xmyoot/esp32c6-epaper-calendar/analysis/report-workflow-tail.txt

### Signal Integrity
[Layer transitions per net, ground return path assessment, trace proximity/crosstalk (with --proximity flag)]

Differential pair length matching: For each detected differential pair (USB D+/D-, Ethernet TX+/TX-, etc.), compute the length delta between the two traces and cite the protocol-specific tolerance. The delta and tolerance are more useful than the raw lengths alone — they tell the designer whether there's margin or a problem. Example format: "D+=75.8mm, D-=75.2mm (delta=0.6mm — within USB 2.0 FS tolerance of ±25mm)." For interfaces with tighter requirements: USB 3.x ±3mm, HDMI ±2mm, DDR ±0.5mm.

### Power & Ground
[Power net routing summary (width, length, current capacity), ground domain identification (AGND/DGND/PGND), zone stitching via density]

### Thermal Analysis
[Thermal pad detection, via counting and adequacy for QFN/DFN packages, zone stitching density, thermal relief settings, tombstoning risk assessment (0201/0402 thermal asymmetry). Cross-reference thermal via count and pad area against each IC's datasheet thermal management section — check recommended via count, via diameter, and exposed pad connection. Verify θJA assumptions match the datasheet's specified board conditions (e.g., JEDEC 2s2p vs actual layer count).

When `analyze_thermal.py` was run, include its junction temperature estimates (Tj per component, margin to Tj_max, thermal score). Cross-reference against datasheet Tj_max values. When the thermal script was not run, estimate manually from power dissipation and package θJA for components with significant power draw (regulators, drivers, power FETs).]

For every IC with an exposed/thermal pad, explicitly report the via count and adequacy in this format: "[Ref] pad [N] ([net]) connected through [count] thermal vias (recommended range: [min]–[max] per datasheet) — [adequate/insufficient]." Example: "U1 pad 41 (GND thermal pad) connected through 12 thermal vias (recommended range: 9–16) — adequate." The thermal via count is one of the most common QFN/DFN layout errors and is always worth calling out with a specific number, even when adequate — it confirms the designer got it right.

### Copper Presence
[Zone copper at component pad locations — from `copper_presence` section. Focus on `no_opposite_layer_copper` list: which components lack zone copper on the opposite layer? Verify this is intentional for capacitive touch pads and antennas (need isolation) vs unexpected for other components (might indicate a zone gap). Also note `same_layer_foreign_zones` — pads sitting on zones they're not connected to, which is normal for tightly-packed power island zones but worth flagging if unexpected.]

### Capacitive Touch Pads
[Include when TP-prefixed components or pad-only footprints appear in `copper_presence.no_opposite_layer_copper`, or when touch controller ICs are detected]

| Pad | Diameter/Size | Position | Opposite-Layer Copper | Keepout Zone? | GND Pour Clearance | Trace Width | Trace Length to Controller |
|-----|---|---|---|---|---|---|---|
| [ref] | [mm] | [x, y] | [none / present (CRITICAL)] | [yes — (x1,y1) to (x2,y2) / NO — flag WARNING] | [distance mm vs app note min] | [mm] | [mm — compare across pads] |

Copper absence vs keepout enforcement: Confirming "no copper" under a touch pad is necessary but not sufficient. That absence could be accidental — a routing change or zone adjustment could fill in copper and kill touch sensitivity. A keepout zone is a DRC rule that prevents this permanently. Check the PCB file for explicit keepout/rule-area objects on the opposite layer under each touch pad. If none exist, flag as WARNING: "no explicit keepout zone under [ref] — copper absence is not enforced by a DRC rule."

Trace length asymmetry: Compute the trace length from each touch pad to the controller IC and compare across all pads. Significant asymmetry (>1.5×) means different parasitic capacitance per channel, which shifts baseline readings and may reduce dynamic range even with firmware calibration. Report the ratio: "TOUCH_2 (41.6mm) is 1.75× longer than TOUCH_1 (23.7mm)."

GND pour clearance: Use the `touch_pad_gnd_clearance` section in `copper_presence` for measured clearance values (`gnd_clearance_mm` per touch pad). Compare against the touch controller's recommended minimum (typically 1.0mm for Espressif, check the specific controller's app note). If the clearance is exactly at the minimum, note this: "GND clearance is 1.0mm — exactly the Espressif minimum. Consider increasing to 1.5mm if sensitivity is marginal." If `touch_pad_gnd_clearance` is not present, measure manually from the PCB layout.

### Antenna Layout
[Include when ANT-prefixed footprints, antenna lib_id patterns, or RF antenna footprints are detected, OR when wireless modules (ESP32, nRF, etc.) with integrated/PCB antennas are present]
- Keepout zone verification: check the `keepout_zones` section in the PCB analyzer output for restriction areas near the antenna footprint. Report the keepout zone coordinates, layer coverage, and restriction types explicitly: "Keepout zone on F.Cu+B.Cu: (x1, y1) to (x2, y2), restrictions: no copper pour, no tracks." The `nearby_components` field shows which components are near each keepout zone. Cross-reference dimensions against the manufacturer's reference layout — many antenna datasheets/app notes specify exact keepout areas.
- Ground plane termination: verify the ground plane ends at the antenna feed point and does not extend under the radiating element
- Matching network placement: components between antenna and RF IC should be close to the antenna with controlled-impedance traces
[If no keepout zones are defined around the antenna, flag as WARNING. For wireless modules (ESP32, nRF, etc.), the module vendor's reference design is the authoritative source for keepout dimensions — these are often the single most important layout constraint for RF performance. Always cite the specific antenna/module reference when verifying keepout adequacy: "Correct per Espressif guidelines" or "Matches nRF52840 reference layout."]

### Decoupling Placement
[Cap-to-IC distances for critical components, flag caps too far from IC power pins. Verify capacitor values and placement distances against each IC's datasheet requirements — many ICs specify maximum distance, minimum capacitance, and ESR limits for input/output decoupling. Flag any deviation from datasheet recommendations.

ESD protection ICs (entries with `category: "esd_bypass"` in the decoupling output) require a low-impedance bypass path for clamping. Their bypass cap should be within 3mm — flag WARNING if >5mm, SUGGESTION if 3-5mm. Common ESD ICs: USBLC6-2SC6, TPD4E05U06, PRTR5V0U2X, IP4220CZ6.]

### Current Capacity
[Per-net trace/via current capacity vs estimated load, narrow signal net warnings]

### DFM Assessment
[JLCPCB standard/advanced tier determination, DFM metrics (min trace width, min clearance, min drill, min annular ring), violation list. All threshold values MUST come from the "Fab House Capabilities" table in standards-compliance.md — do not substitute from memory.]

### Silkscreen
[Board text count, reference designator visibility, documentation warnings, values on silk]

### Connectivity
[Routing completeness, unrouted net count and list]

## Schematic ↔ PCB Cross-Reference
[Include when both schematic and PCB were analyzed — this catches the most dangerous bugs. Use `statistics.total_nets` from both analyzers for net count comparison — do not mix net counts from different sections or manual counting methods, as the schematic may include internal unnamed nets that the PCB doesn't.]
### Component Count Match — [Schematic (excl. power symbols) vs PCB footprint count]
### Pin-Net Verification — [ALL components: schematic pin mapping vs PCB pad mapping. Table: Ref | Pins | All Match | Mismatches. Do not sample — verify every component including connectors, transistors, diodes.]
This verification must happen at the PCB pad level, not just the schematic pin level. The schematic tells you pin 1 connects to net X; the PCB tells you pad 1 connects to net X. If the library footprint has pad numbering that doesn't match the symbol's pin numbering, the schematic and PCB will be internally consistent but the board will be wrong. For each IC, transistor, and connector, verify both directions: schematic pin N → net X, AND PCB pad N → net X, AND the physical pad position matches the datasheet's pin diagram for that specific package. Example format: "Q1: 1=G(MAP_RED), 2=S(GND), 3=D(+5V)." This catches the most dangerous class of bug — a library footprint with wrong pad numbering passes all consistency checks but produces a non-functional board.
### Connector Pinout Tables — [For connectors with >2 pins (debug headers, programming headers, multi-pin interfaces), include a pin mapping table]

| Connector | Pin | Net | Function |
|---|-----|-----|---|
| J1 | 1 | RESET | MCU reset |
| ... | ... | ... | ... |

[This is especially important for programming/debug headers, USB connectors, and board-to-board interfaces where miswiring is common and consequences are severe.]

### Footprint Match — [Schematic Footprint property vs actual PCB footprint]
### Value/MPN Consistency — [Spot-check values and MPNs between schematic and PCB]
### DNP Consistency — [Components marked DNP in schematic should not have routing on PCB]

## Gerber Analysis
[Include when gerber directory was analyzed]
### Layer Completeness — [Found vs missing required/recommended layers, source identification]
### Drill Classification — [Via count, component holes, mounting holes, classification method]
### Alignment Verification — [Layer alignment check, extent comparison]
### Pad Summary — [SMD vs THT aperture counts, via apertures, heatsink apertures]
### Board Dimensions — [From gerber extents, compare against PCB if both analyzed]

## Interface Summary
[One-line summary of each external interface: connector type, protection, protocol, pin mapping]
[Examples: USB-C (ESD: yes, CC: 5.1kΩ), SWD (J1, no ESD), CAN (120Ω term, PESD2CAN)]

## Quality & Manufacturing

### Assembly Complexity
[Score, SMD/THT ratio, difficulty breakdown (fine-pitch, BGA, QFN), dominant package, unique footprint count]

### Sourcing Audit
[MPN coverage %, missing MPNs list, missing distributor part numbers. Do not recommend or prefer any specific distributor by name — keep sourcing observations neutral.]

### Component Lifecycle Status
[**Include when `--lifecycle` flag was used on the schematic analyzer.** Report any NRND (not recommended for new designs), EOL (end of life), or obsolete components from the `lifecycle_audit` output. For each flagged part: MPN, current status, last-buy date if known, and suggested action (find alternate, stock up, redesign). If lifecycle audit was not run, note: "Lifecycle audit not performed — [reason: no API keys / no network / no MPNs]."]

### BOM Optimization
[Unique passive value counts per type, total unique footprints, single-use passive values, consolidation opportunities]

### Test Coverage
[Test points found and nets covered, debug connectors, uncovered critical nets]

### USB Compliance
[If applicable: connector type, ESD protection, CC resistors, VBUS protection, D+/D- impedance]

### Simulation Readiness
[Components likely simulatable vs needing SPICE models, coverage percentage]

### Ordering Notes
[Practical manufacturing summary for ordering — this section bridges the design review and the fabrication order. Extract surface finish from the PCB stackup (`copper_finish` field in setup section), solder mask color from board setup, and board thickness from the stackup layer sum. Designers use this to configure their PCB order, so always include it when a PCB was analyzed.]
- Layer count: [N] layers, surface finish: [HASL/ENIG/OSP — from PCB stackup `copper_finish`], solder mask color: [green/black/etc. — from board setup]
- Stencil: [recommend if SMD components present, note if fine-pitch requires frameless stencil]
- Board thickness: [standard 1.6mm or custom — from stackup total thickness]
- DFM tier: [standard vs advanced capability requirements based on min trace/space/drill from DFM section]
- Copper weight: [1oz/2oz based on current requirements — from stackup copper layer thickness, 0.035mm = 1oz]
- Assembly notes: [reflow profile considerations, mixed SMD/THT implications]
- Special requirements: [impedance control, via-in-pad, castellated edges, etc. if applicable]

## All Issues & Suggestions
[Complete list of all findings. CRITICAL and WARNING items were already shown in the Critical Findings section at the top — repeat them here with full detail and context. SUGGESTION items appear here only.]

| Severity | Issue | Detail |
|---|---|---|
| CRITICAL | [Board won't function, safety hazard, or fabrication failure] | [Full explanation, datasheet citation, affected components] |
| WARNING  | [Suboptimal but board may work, potential reliability issue] | [Full explanation, recommendation] |
| SUGGESTION | [Improvements, best practices, documentation gaps] | [Rationale, optional fix] |

## Positive Findings
[Numbered list of things the design does well — builds designer confidence and validates good practices. Examples:]
1. All ICs have local decoupling capacitors within 3mm — good EMC practice
2. USB differential pairs are length-matched within 0.2mm — well within USB 2.0 spec (25ps)
3. Feedback divider values for U3 (TPS61023) match the datasheet application circuit exactly (590K/200K → 2.37V)
4. Thermal vias under QFN packages: U1 has 9 vias (TI recommends 6-9) — adequate thermal path

## Analyzer Gaps
[Numbered list of things the analyzer missed, got wrong, or couldn't detect — transparency about tool limitations. Examples:]
1. Crystal Y1 (32.768 kHz) load capacitor validation skipped — no CL spec in analyzer output for this crystal
2. Connector J3 pinout could not be verified — no datasheet found for this custom connector
3. Analog ground (AGND) to digital ground (DGND) connection point not analyzed — single-point connection must be verified visually
4. U5 (custom library symbol from `mylib:XYZ123`) — pin mapping not verified against datasheet due to missing MPN
```

## Analyzer Output Field Reference

Quick reference for what each analyzer produces, to ensure no analysis dimension is missed in the report.

### Schematic Analyzer (`analyze_schematic.py`)

| Output Section | Report Section | Key Fields |
|---|---|---|
| `statistics` | Component Summary | component_types, power_rails, missing_mpn |
| `bom` | Component Summary, BOM Optimization | deduplicated parts with quantities |
| `components` | IC Spot-Check, throughout | full component details with pin_uuids, parsed_value |
| `nets` | Net Tracing, throughout | per-net pin lists with pin_type |
| `subcircuits` | Power Tree | auto-detected power/signal subcircuits |
| `ic_pin_analysis` | MCU pin audit | per-IC pin utilization summary |
| `findings[] (detector: power_regulators)` | Power Regulators | topology, vref_source, vout_estimate, vout_net_mismatch, inverting |
| `findings[] (detector: feedback_networks)` | Feedback Networks | R_top, R_bottom, vref, vout, vref_source |
| `findings[] (detector: voltage_dividers)` | Voltage Dividers | ratio, output_voltage |
| `findings[] (detector: rc_filters)` | RC/LC Filters | cutoff_hz, filter_type |
| `findings[] (detector: lc_filters)` | RC/LC Filters | resonant_freq_hz |
| `findings[] (detector: opamp_circuits)` | Op-Amp Circuits | configuration, gain |
| `findings[] (detector: protection_devices)` | Protection Devices | type, placement |
| `findings[] (detector: transistor_circuits)` | Transistor Circuits | load_type (motor/heater/fan/solenoid/etc.), is_pchannel, gate_drive |
| `findings[] (detector: bridge_circuits)` | Bridge Circuits | topology, half_bridges, driver_ics |
| `findings[] (detector: crystal_circuits)` | Crystal Circuits | cload, frequency |
| `findings[] (detector: current_sense)` | Current Sense | shunt_value, gain |
| `findings[] (detector: decoupling_analysis)` | Decoupling Analysis | per-rail cap inventory |
| `findings[] (detector: buzzer_speaker_circuits)` | Buzzer/Speaker | driver topology |
| `findings[] (detector: rf_chains)` | RF Chains | component chain |
| `findings[] (detector: bms_systems)` | BMS Systems | cell monitoring |
| `findings[] (detector: ethernet_interfaces)` | Ethernet | magnetics, PHY |
| `findings[] (detector: memory_interfaces)` | Memory | bus width |
| `findings[] (detector: key_matrices)` | Key Matrices | row/col count |
| `findings[] (detector: isolation_barriers)` | Isolation | isolation type |
| `findings[] (detector: battery_chargers)` | Battery Chargers | charger_type, charge_current |
| `findings[] (detector: motor_drivers)` | Motor Drivers | driver_type (stepper/dc_brushed) |
| `findings[] (detector: esd_coverage_audit)` | ESD Coverage | per-connector coverage, risk_level |
| `findings[] (detector: debug_interfaces)` | Debug Interfaces | SWD/JTAG, target_ic |
| `findings[] (detector: power_path)` | Power Path | load switches, ideal diodes, USB PD |
| `findings[] (detector: adc_circuits)` | ADC Circuits | external ADCs, voltage references |
| `findings[] (detector: reset_supervisors)` | Reset/Supervisor | supervisors, watchdogs, RC reset |
| `findings[] (detector: clock_distribution)` | Clock Distribution | generators, PLLs, oscillator outputs |
| `findings[] (detector: display_interfaces)` | Display/Touch | display type, touch controller |
| `findings[] (detector: sensor_interfaces)` | Sensor Fusion | motion/environmental/magnetic, interrupt pins |
| `findings[] (detector: level_shifters)` | Level Shifters | IC + discrete, supply domains |
| `findings[] (detector: audio_circuits)` | Audio Circuits | amplifiers, codecs, I2S |
| `findings[] (detector: led_driver_ics)` | LED Driver ICs | PWM/matrix/constant-current |
| `findings[] (detector: rtc_circuits)` | RTC Circuits | battery backup, crystal pairing |
| `findings[] (detector: led_audit)` | LED Audit | current limiting validation |
| `findings[] (detector: thermocouple_rtd)` | Thermocouple/RTD | amplifiers, RTD interfaces |
| `findings[] (detector: power_sequencing_validation)` | Power Sequencing | power tree, enable chains, issues |
| `findings[] (detector: design_observations)` | Design Observations | automated findings |
| `design_analysis.net_classification` | Net Classification | per-net class (power/data/analog/output_drive/etc.) |
| `design_analysis.power_domains` | Power Domains | per-IC rail mapping with IO rails |
| `design_analysis.cross_domain_signals` | Cross-Domain Signals | voltage equivalence filtering |
| `design_analysis.bus_analysis` | Bus Topology | I2C/SPI/UART/CAN with COPI/CIPO support |
| `design_analysis.differential_pairs` | Differential Pairs | suffix-pair matching, protocol guessing |
| `design_analysis.erc_warnings` | ERC Warnings | type, severity |
| `design_analysis.passive_warnings` | Passive Warnings | unusual values |
| `connectivity_issues` | Connectivity Issues | unconnected, single-pin, multi-driver |
| `pdn_impedance` | PDN Impedance | per-rail impedance with MLCC parasitics |
| `power_budget` | Power Budget | load vs capacity |
| `power_sequencing` | Power Sequencing | EN/PG chains |
| `sleep_current_audit` | Sleep Current | per-rail with regulator Iq, EN detection |
| `inrush_analysis` | Inrush Analysis | per-regulator inrush (automated); also manually consider IC supply pin abs max ratings and capacitor charging through connectors |
| `ground_domains` | Power & Ground | AGND/DGND/PGND separation |
| `sourcing_audit` | Sourcing Audit | MPN and distributor PN coverage (report neutrally, no distributor preference) |
| `bom_optimization` | BOM Optimization | value consolidation |
| `test_coverage` | Test Coverage | test points, debug connectors |
| `assembly_complexity` | Assembly Complexity | score, difficulty breakdown |
| `usb_compliance` | USB Compliance | connector, ESD, CC |
| `simulation_readiness` | Simulation Readiness | SPICE model coverage |
| `label_shape_warnings` | Label Warnings | direction mismatches |
| `pwr_flag_warnings` | PWR_FLAG | missing flags |
| `footprint_filter_warnings` | Footprint Filters | library mismatches |
| `annotation_issues` | Label Warnings | duplicate/missing refs |
| `property_issues` | Quality | property pattern issues |
| `placement_analysis` | (spatial context) | component clusters, grid |
| `alternate_pin_summary` | MCU pin audit | alt function usage |

### PCB Analyzer (`analyze_pcb.py`)

| Output Section | Report Section | Key Fields |
|---|---|---|
| `statistics` | Board Overview | copper_layers_used (tracks+vias+zones), layer names, SMD/THT counts |
| `layers` | Board Overview | full layer stack |
| `setup` | Board Overview | thickness, mask clearance |
| `board_outline` | Board Overview | bounding box, edge geometry |
| `board_metadata` | Board Overview | title block, paper |
| `footprints` | Footprint Placement | per-footprint pads, nets, schematic cross-ref (sch_path, sch_sheetname) |
| `component_groups` | Footprint Placement | grouped by reference prefix |
| `tracks` | Trace Routing | width/layer distribution |
| `vias` | Via Analysis | size distribution, via_analysis (types, annular ring, via-in-pad, tenting) |
| `zones` | Power & Ground | per-zone net, layers, outline/filled bbox, fill area, fill_ratio, thermal settings |
| `connectivity` | Connectivity | routing completeness, unrouted list |
| `net_lengths` | Signal Integrity | per-net trace length and layer transitions |
| `power_net_routing` | Power & Ground | power net width/length/current capacity |
| `ground_domains` | Power & Ground | AGND/DGND domains, multi-domain components |
| `findings[] (detector: analyze_current_capacity)` | Current Capacity | per-net capacity vs load |
| `findings[] (detector: analyze_thermal_vias)` | Thermal Analysis | zone stitching density |
| `findings[] (detector: analyze_thermal_pad_vias)` | Thermal Analysis | per-footprint thermal pad via count and adequacy; `effective_via_count` weights by `(drill/0.3)²` — see pcb-layout-analysis.md for methodology |
| `decoupling_placement` | Decoupling Placement | cap-to-IC distances |
| `findings[] (detector: analyze_placement)` | Footprint Placement | courtyard overlaps, edge clearance |
| `placement_density` | Footprint Placement | density metrics |
| `layer_transitions` | Signal Integrity | per-net layer change tracking |
| `silkscreen` | Silkscreen | ref visibility, documentation warnings |
| `dfm_summary` | DFM Assessment | tier, metrics, violation_count |
| `findings[] (category: dfm)` | DFM Assessment | individual violations |
| `findings[] (detector: analyze_tombstoning_risk)` | Manufacturing | at-risk 0201/0402 components, thermal asymmetry reasons |
| `findings[] (detector: analyze_copper_presence)` | Copper Presence | no_opposite_layer_copper, same_layer_foreign_zones, touch_pad_gnd_clearance |
| `copper_presence_summary` | Copper Presence | opposite_layer_summary |

### Gerber Analyzer (`analyze_gerbers.py`)

| Output Section | Report Section | Key Fields |
|---|---|---|
| `statistics` | Gerber Analysis | file counts, total holes/flashes/draws |
| `completeness` | Layer Completeness | found/missing layers, source |
| `alignment` | Alignment Verification | aligned status, layer extents |
| `drill_classification` | Drill Classification | vias, component holes, mounting holes |
| `pad_summary` | Pad Summary | SMD/THT/via/heatsink apertures |
| `board_dimensions` | Board Dimensions | from gerber extents |
| `gerbers` | (per-layer detail) | aperture functions, trace widths, X2 attributes |
| `drills` | (per-file detail) | tool list, hole counts |

## Severity Definitions

Use these consistently across all reports:

- **CRITICAL**: The board will not function as designed, or there is a safety/damage risk. Examples: swapped pins in symbol library, output contention from shorted op-amp outputs, regulator can't start, missing power path, thermal pad without ground vias on QFN.
- **WARNING**: The board may work but has a reliability, performance, or compliance concern. Examples: floating digital inputs, missing flyback diode on inductive load, cross-domain signal without level shifter, inadequate decoupling, regulator thermal margin tight.
- **SUGGESTION**: Best-practice improvement or documentation gap that doesn't affect functionality. Examples: missing MPNs, no test points on power rails, DNP components not marked, footprint filter mismatch with custom library.

## Writing Principles

### Be specific and actionable
Bad: "Power supply may have issues"
Good: "LMR51450 (U7) feedback divider R12/R13 gives Vout = 0.6*(1+100k/47k) = 1.88V, but target rail is 3.3V. Vref for LMR51450 is 1.0V (not 0.6V assumed by analyzer), giving actual Vout = 1.0*(1+100k/47k) = 3.13V — still 5% below target."

### Show your work
Include the calculation, the datasheet reference, and the conclusion. EE designers want to verify your reasoning, not just trust a pass/fail label.

### Distinguish analyzer findings from manual findings
Make it clear what came from the analyzer JSON vs what you found by reading the raw schematic. This helps designers understand the tool's coverage.

### Call out false positives explicitly
When the analyzer flags something that isn't actually a problem, explain why it's a false positive. This prevents designers from wasting time investigating non-issues and helps calibrate trust in the analyzer.

### Validate calculations, don't just echo them
