xmyoot/esp32c6-epaper-calendar/manufacturing/drill-report.txt

Drill report for EPD_C6_RevA.kicad_pcb
Created on 2026-10-20T07:51:54

Copper Layer Stackup:
    =============================================================
    L1 :  F.Cu                      front
    L2 :  B.Cu                      back

Drill file 'EPD_C6_RevA-PTH.drl' contains
    plated through holes:
    =============================================================
    T1  0.300mm  0.0118"  (52 holes))
    T2  1.000mm  0.0394"  (14 holes))

    Total plated holes count 66

Drill file 'EPD_C6_RevA-NPTH.drl' contains
    unplated through holes:
    =============================================================
    T1  2.700mm  0.1063"  (4 holes))

    Total unplated holes count 4
