xmyoot/esp32c6-epaper-calendar/references/XIAO-schematic.txt

    1   2                                        3   4                                          5         6                                              7     8

A                                                                                                                                                                          A

B                                                                                                                                                                          B

            01 Descriptions                              02 Block    Diagram                                     03 Power

            File:    01 Descriptions.kicad_sch           File:   02 Block   Diagram.kicad_sch                    File:   03 Power.kicad_sch

C                                                                                                                                                                          C

             04 ESP32 C6

             File:    04 ESP32 C6.kicad_sch
D                                                                                                                                                                          D

E                                                                                                                                                                          E

                                                                                                                         Seeed Studio
                                                                                                                         Sheet: /
                                                                                                                         File: XIAO ESP32 C6.kicad_sch

                                                                                                                         Title:    XIAO ESP32-C6
                                                                                                    CCBY-SA4.0           Size: A3
                                                                                                                         KiCad E.D.A. 9.0.6
                                                                                                                                            Date: 2026-01-14   Rev: V1.0
                                                                                                                                                               Id: 1/5
F                                                                                                                                                                          F
    1   2                                        3   4                                          5         6                                              7     8

    1   2                            3                   4   5               6                                     7   8

A                                                                                                                                  A

            Version                       Descriptions              Date           Name

             v1.0     Initial   version                          2024/3/28       Linus.Liao

B                                                                                                                                  B

C                                                                                                                                  C

D                                                                                                                                  D

E                                                                                                                                  E

                                                                                 Seeed Studio
                                                                                 Sheet: /01 Descriptions/
                                                                                 File: 01 Descriptions.kicad_sch

                                                                                 Title:   XIAO ESP32-C6
                                                                 CCBY-SA4.0      Size: A3
                                                                                 KiCad E.D.A. 9.0.6
                                                                                                    Date: 2026-01-14   Rev: V1.0
                                                                                                                       Id: 1/5
F                                                                                                                                  F
    1   2                            3                   4   5               6                                     7   8

    1   2   3   4   5         6                                    7       8

A                                                                                      A

B                                                                                      B

C                                                                                      C

D                                                                                      D

E                                                                                      E

                                     Seeed Studio
                                     Sheet: /02 Block Diagram/
                                     File: 02 Block Diagram.kicad_sch

                                     Title:   XIAO ESP32-C6
                        CCBY-SA4.0   Size: A3
                                     KiCad E.D.A. 9.0.6
                                                        Date: 2026-01-14   Rev: V1.0
                                                                           Id: 2/5
F                                                                                      F
    1   2   3   4   5         6                                    7       8

    1                                                                 2                                                                             3                                                              4                               5                         6                                                              7                                                            8

A                                                                                                                                                                                                                                                                                                                                                                                                                    A

                                                                                                                                                                                     VBUS
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

                                                                                                                                        +3V3                 C13             C14             C15                           C16
                                                                                                                                                             10uF            1uF             100nF                         100nF                                                              GND
                                                                                                                                                             10V,X5R         6.3V,X5R        10V,X5R                       10V,X5R     +3V3

                                                                                                                                            2
                                                                                                                                                R23                                                                                                                                     0R
                                            ANT2                                                                                                10K                                                                                                                                       2
                                      U.FL-R-SMT-1                                                                                          1   1%                                                                                         C5                 C12                       1%                                           Layout þÿnoteÿ
                                                                                                                                                                                   Close     to the chip's               VDDA3P3                              10nF
                                                                                                             C19                 10pF                  GND                                                                                 1uF                                            1                                          SDIO wiring of equal     length   needs   to be controlled   within      3mil
                                                                                                                                                                                                                                           6.3V,X5R           16V,X7R
                                                                                                         þÿ50VÿNPO
                                                     1      L3     1 2.7nH      2                                                                                                                                                                                                       R12
                            GND               D
                                                                                                             R24 1              2 5.1K                                                                                                                                                                                                 GPIO23/SDIO_D3
B                                                                                          C24                                                                                                                                                                                                                                                                                                                                       B
                                                                 C23                                             1%                                                                                                                                                                                                                    GPIO22/SDIO_D2
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
