xmyoot/esp32c6-epaper-calendar/analysis/placement.png

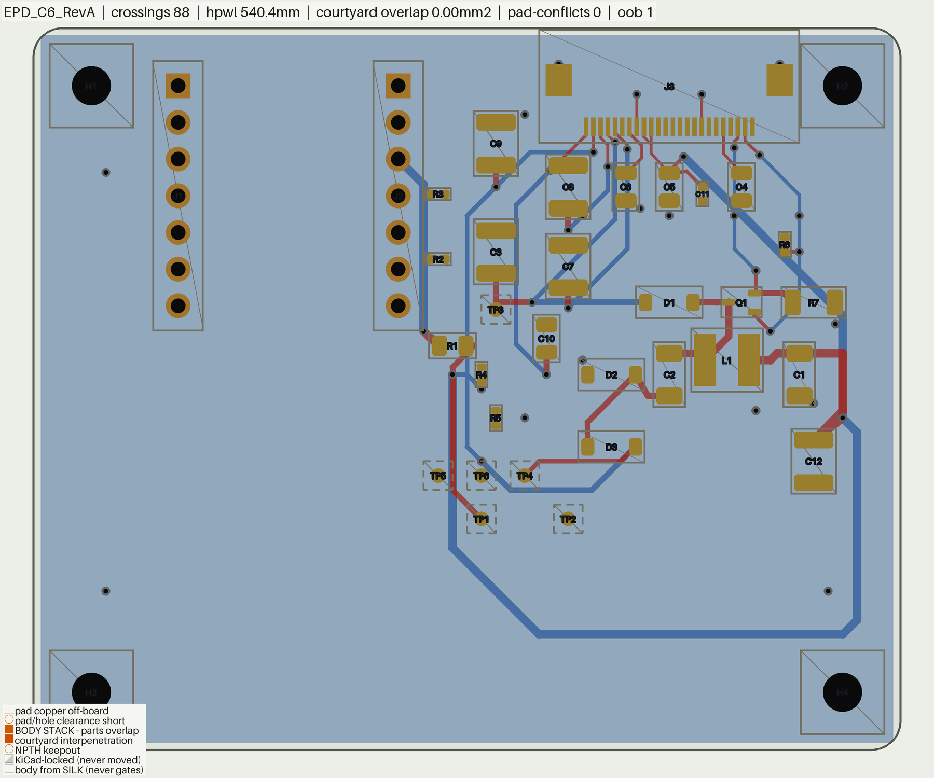
analysis/placement.png
