xmyoot/esp32c6-epaper-calendar/references/GDEY075T7-reference-p40.png

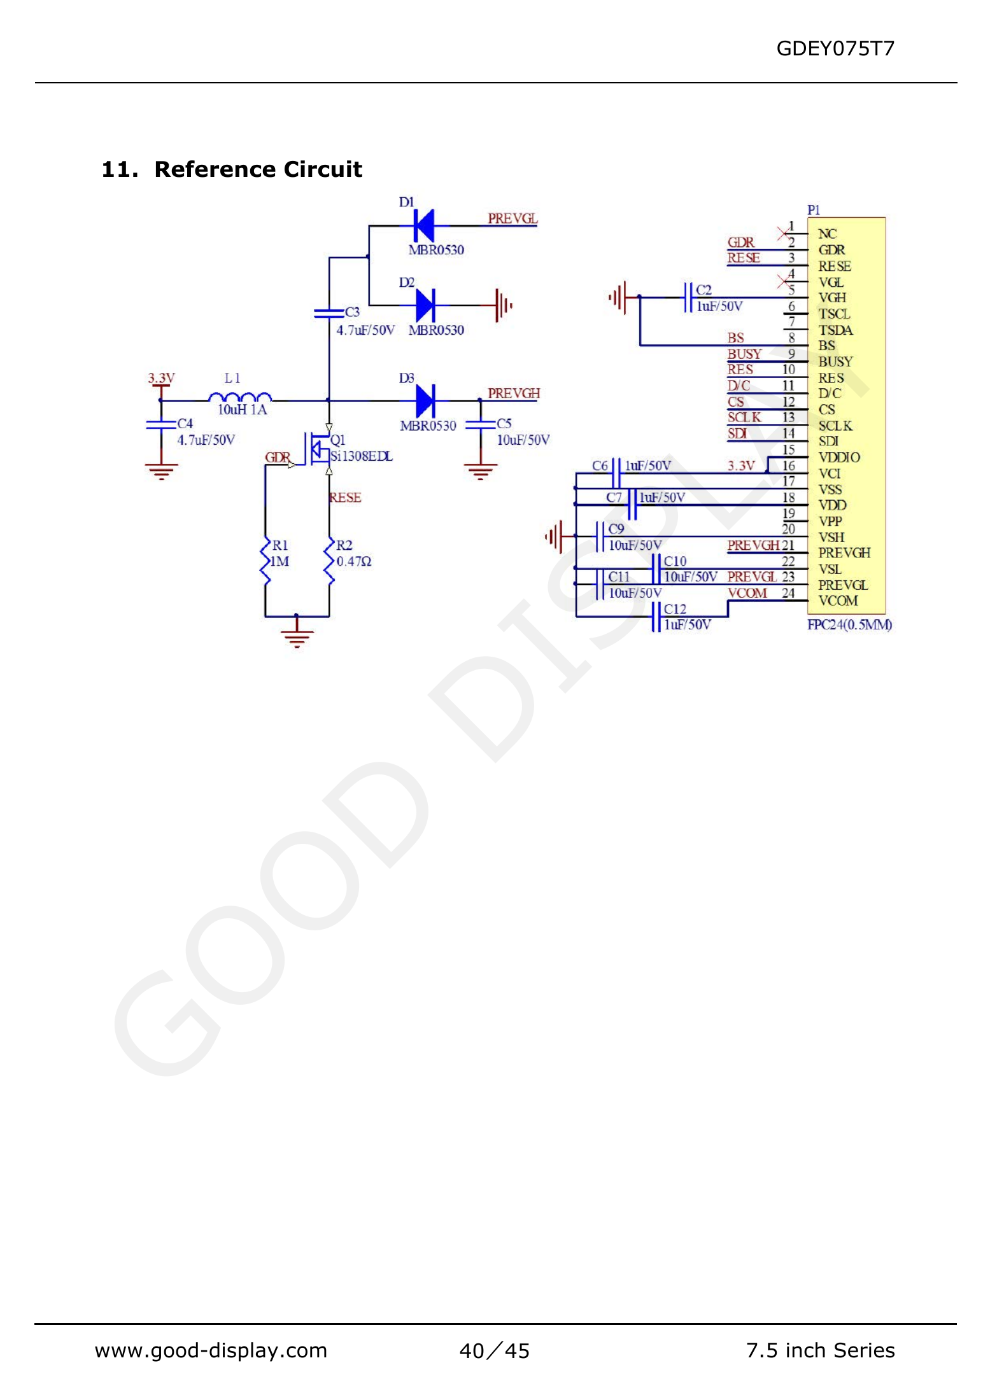
references/GDEY075T7-reference-p40.png
