xmyoot/esp32c6-epaper-calendar/references/panel-07.png

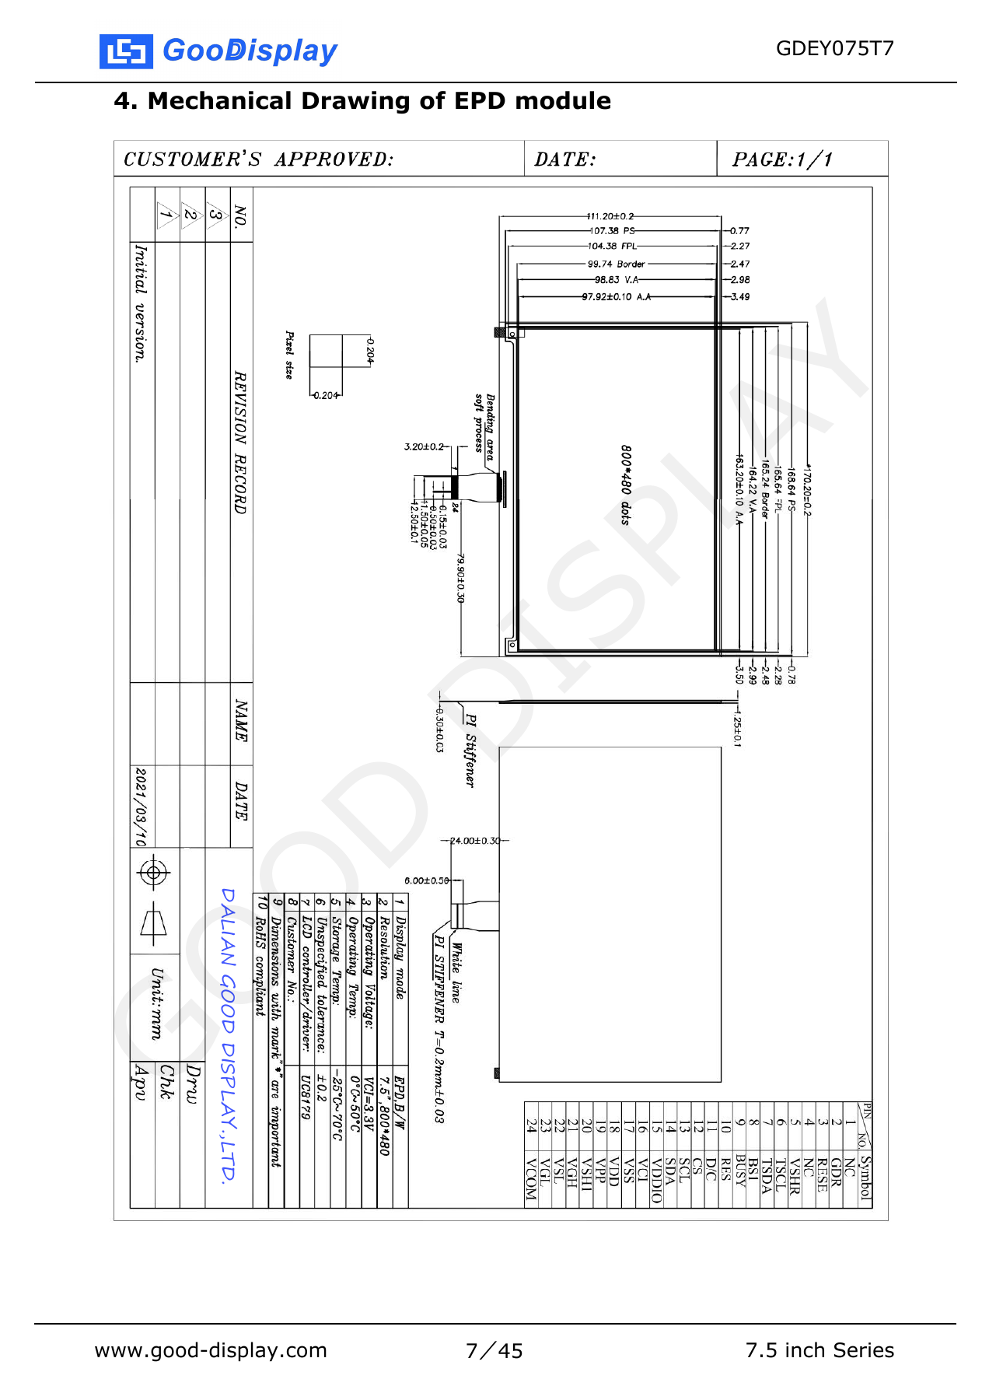
references/panel-07.png
