xmyoot/esp32c6-epaper-calendar/references/panel-08.png

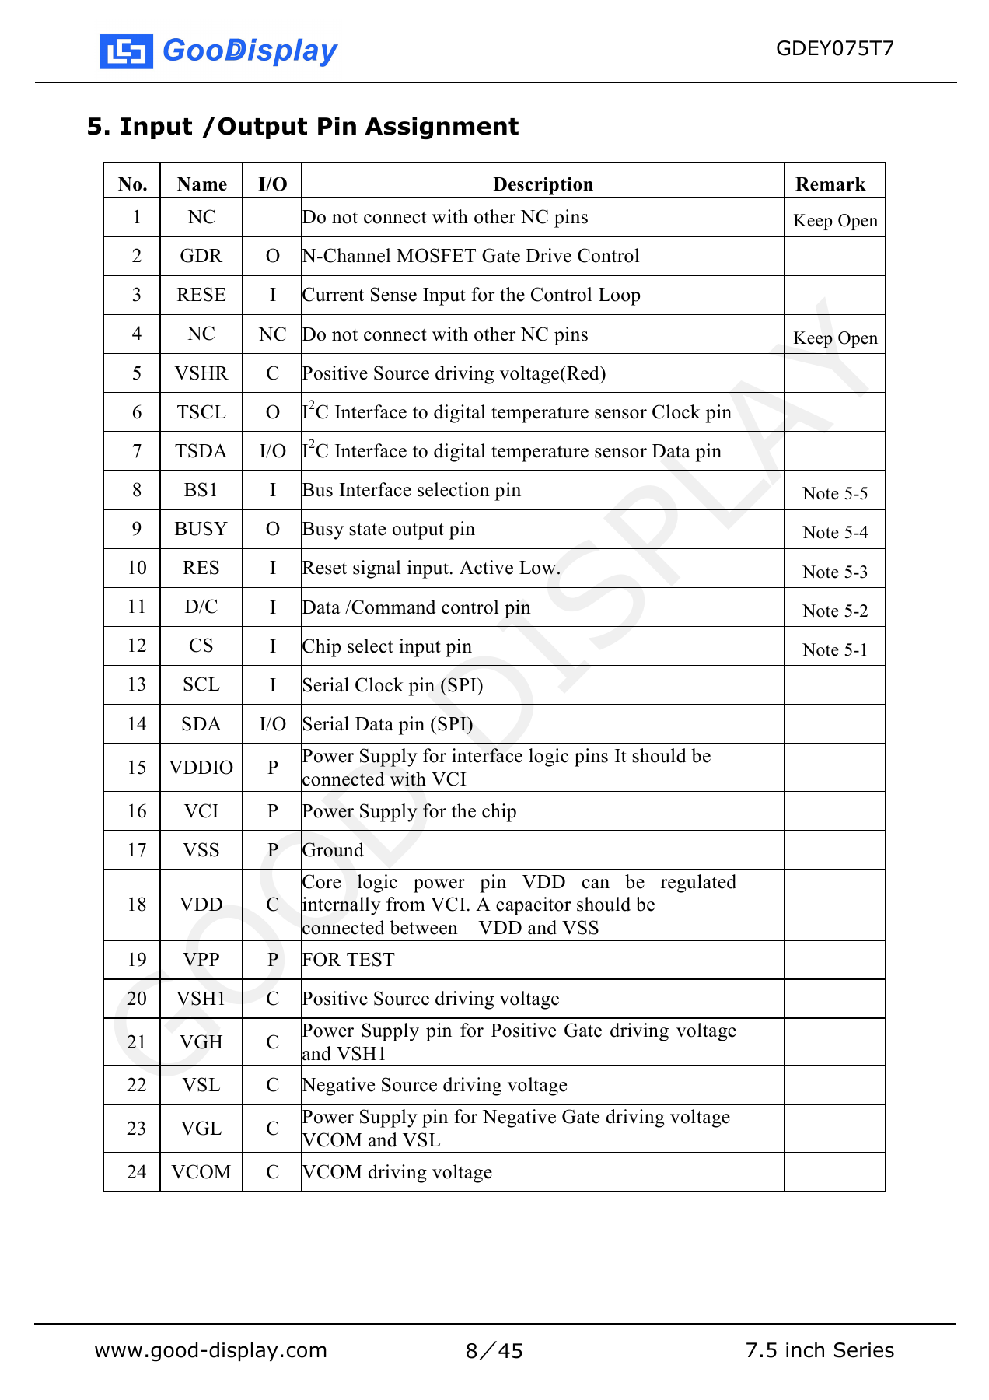
references/panel-08.png
