xmyoot/esp32c6-epaper-calendar/references/panel-09.png

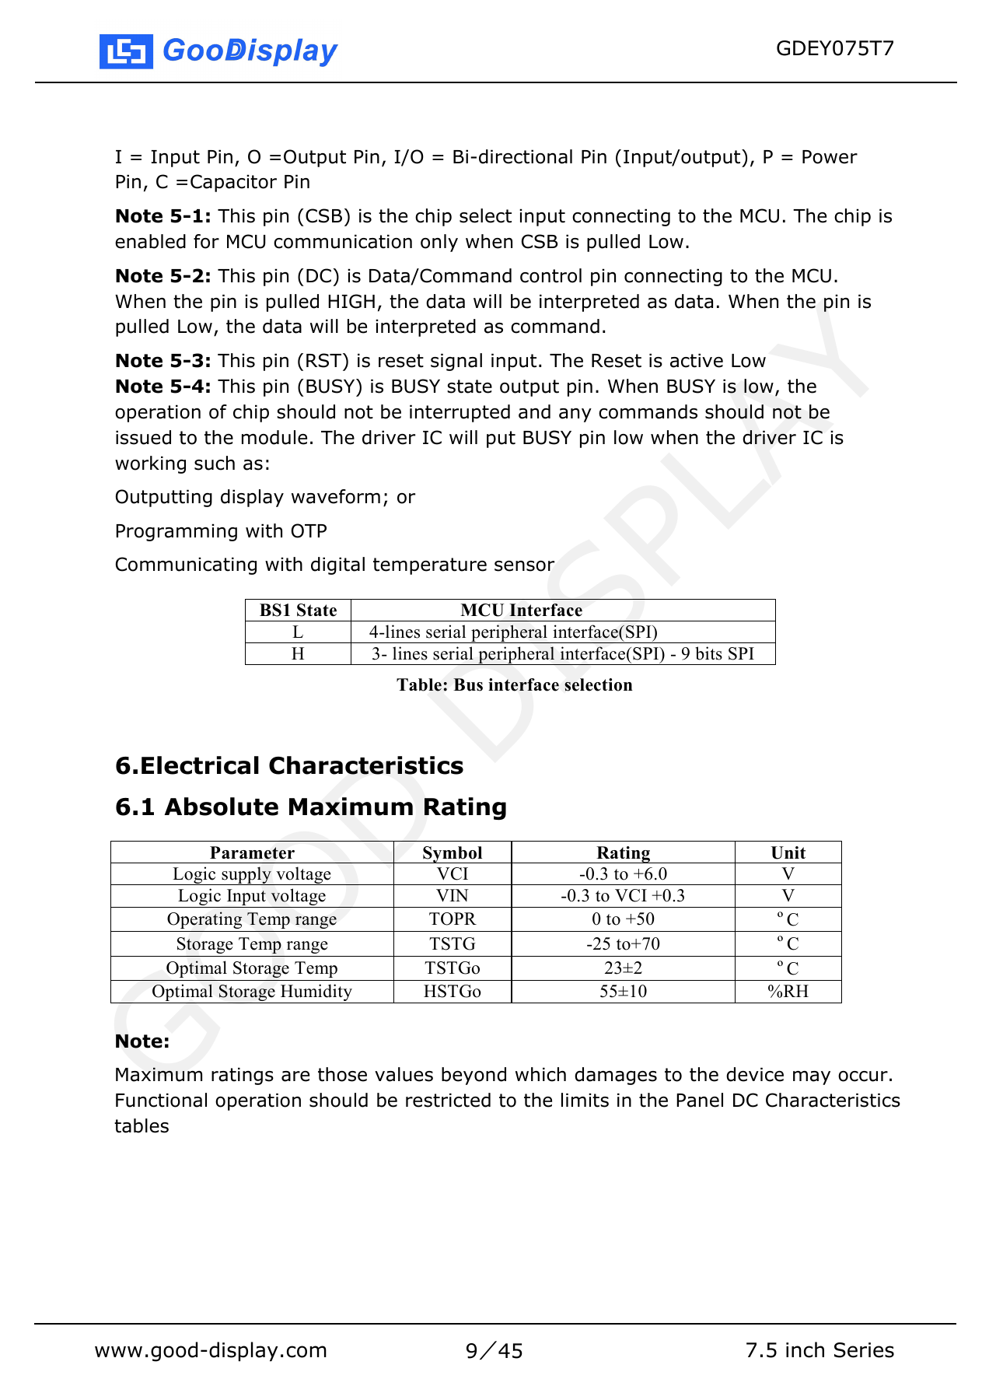
references/panel-09.png
