xmyoot/esp32c6-epaper-calendar/references/panel-10.png

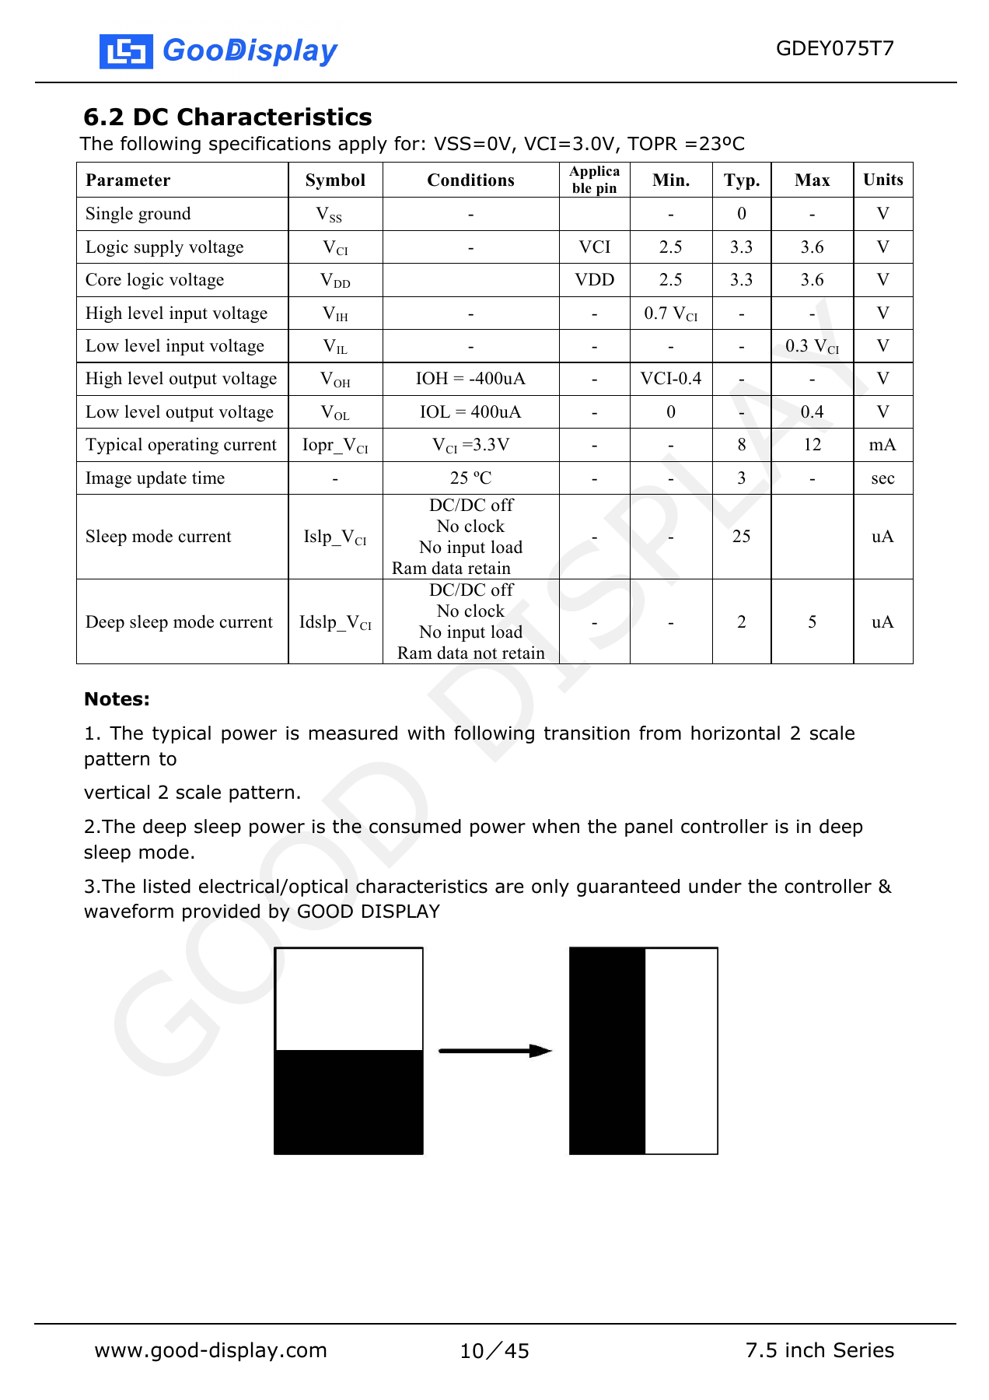
references/panel-10.png
