xmyoot/esp32c6-epaper-calendar/analysis/assembly-final-1.png

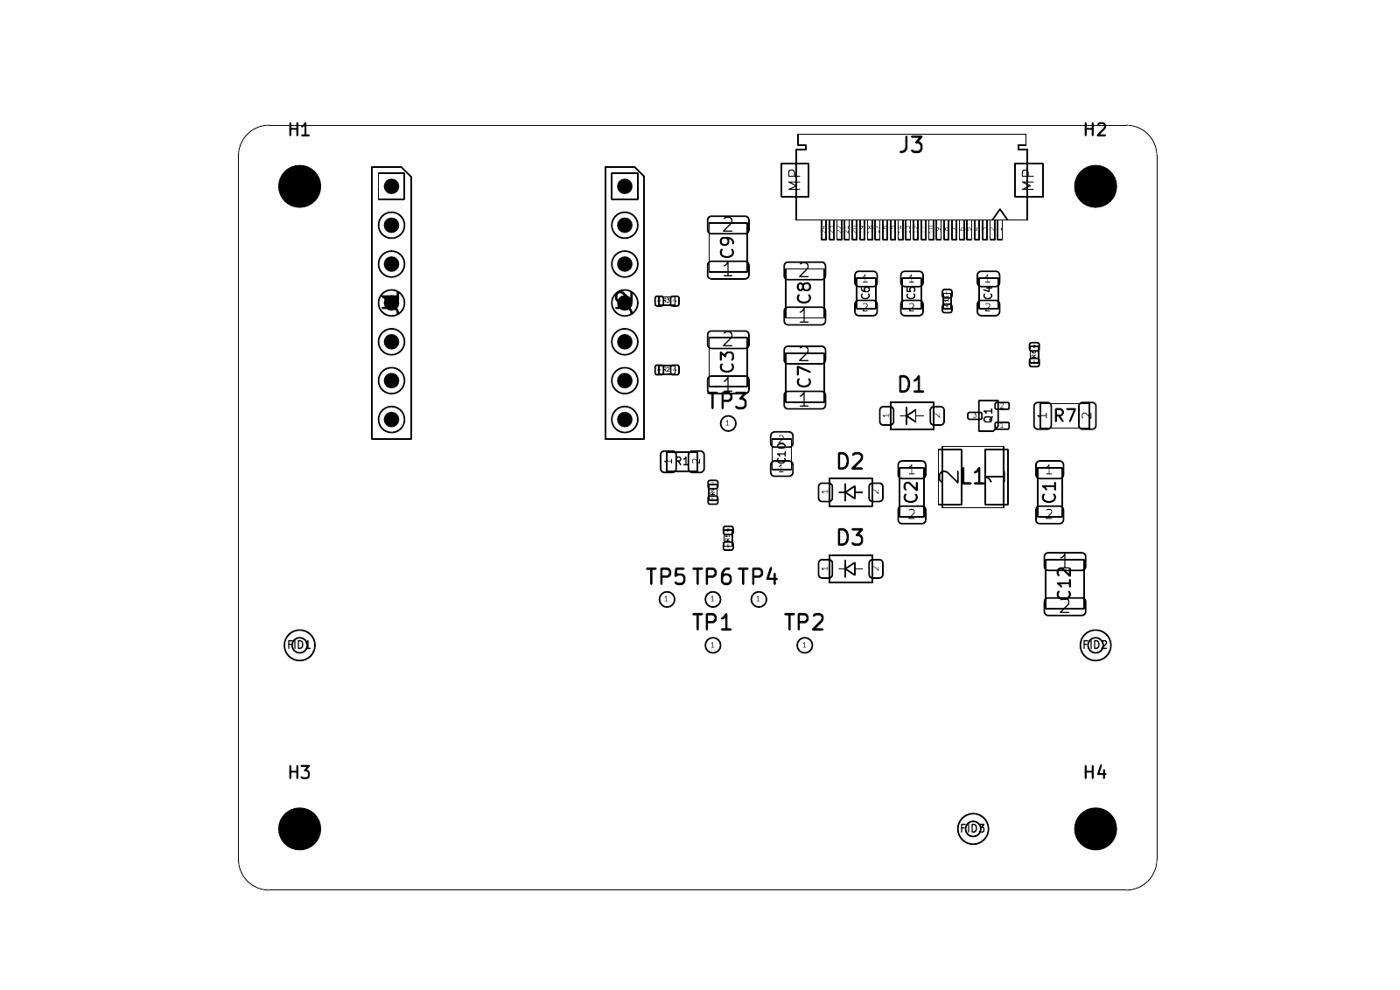
analysis/assembly-final-1.png
