xmyoot/esp32c6-epaper-calendar/analysis/assembly-final-2.png

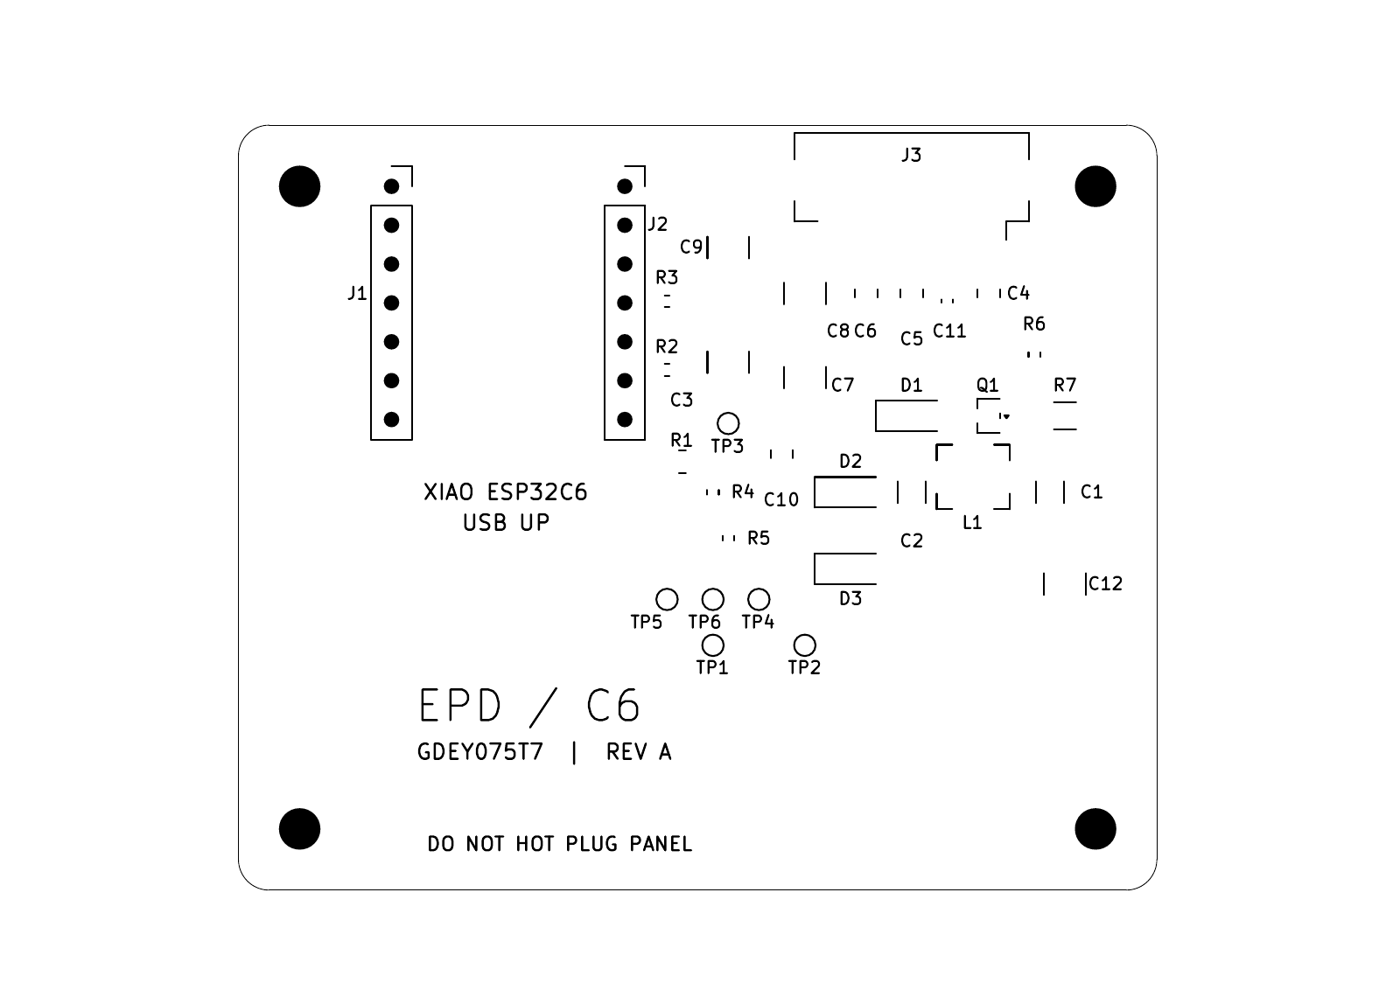
analysis/assembly-final-2.png
