xmyoot/esp32c6-epaper-calendar/docs/EPD_C6_RevA-schematic.pdf

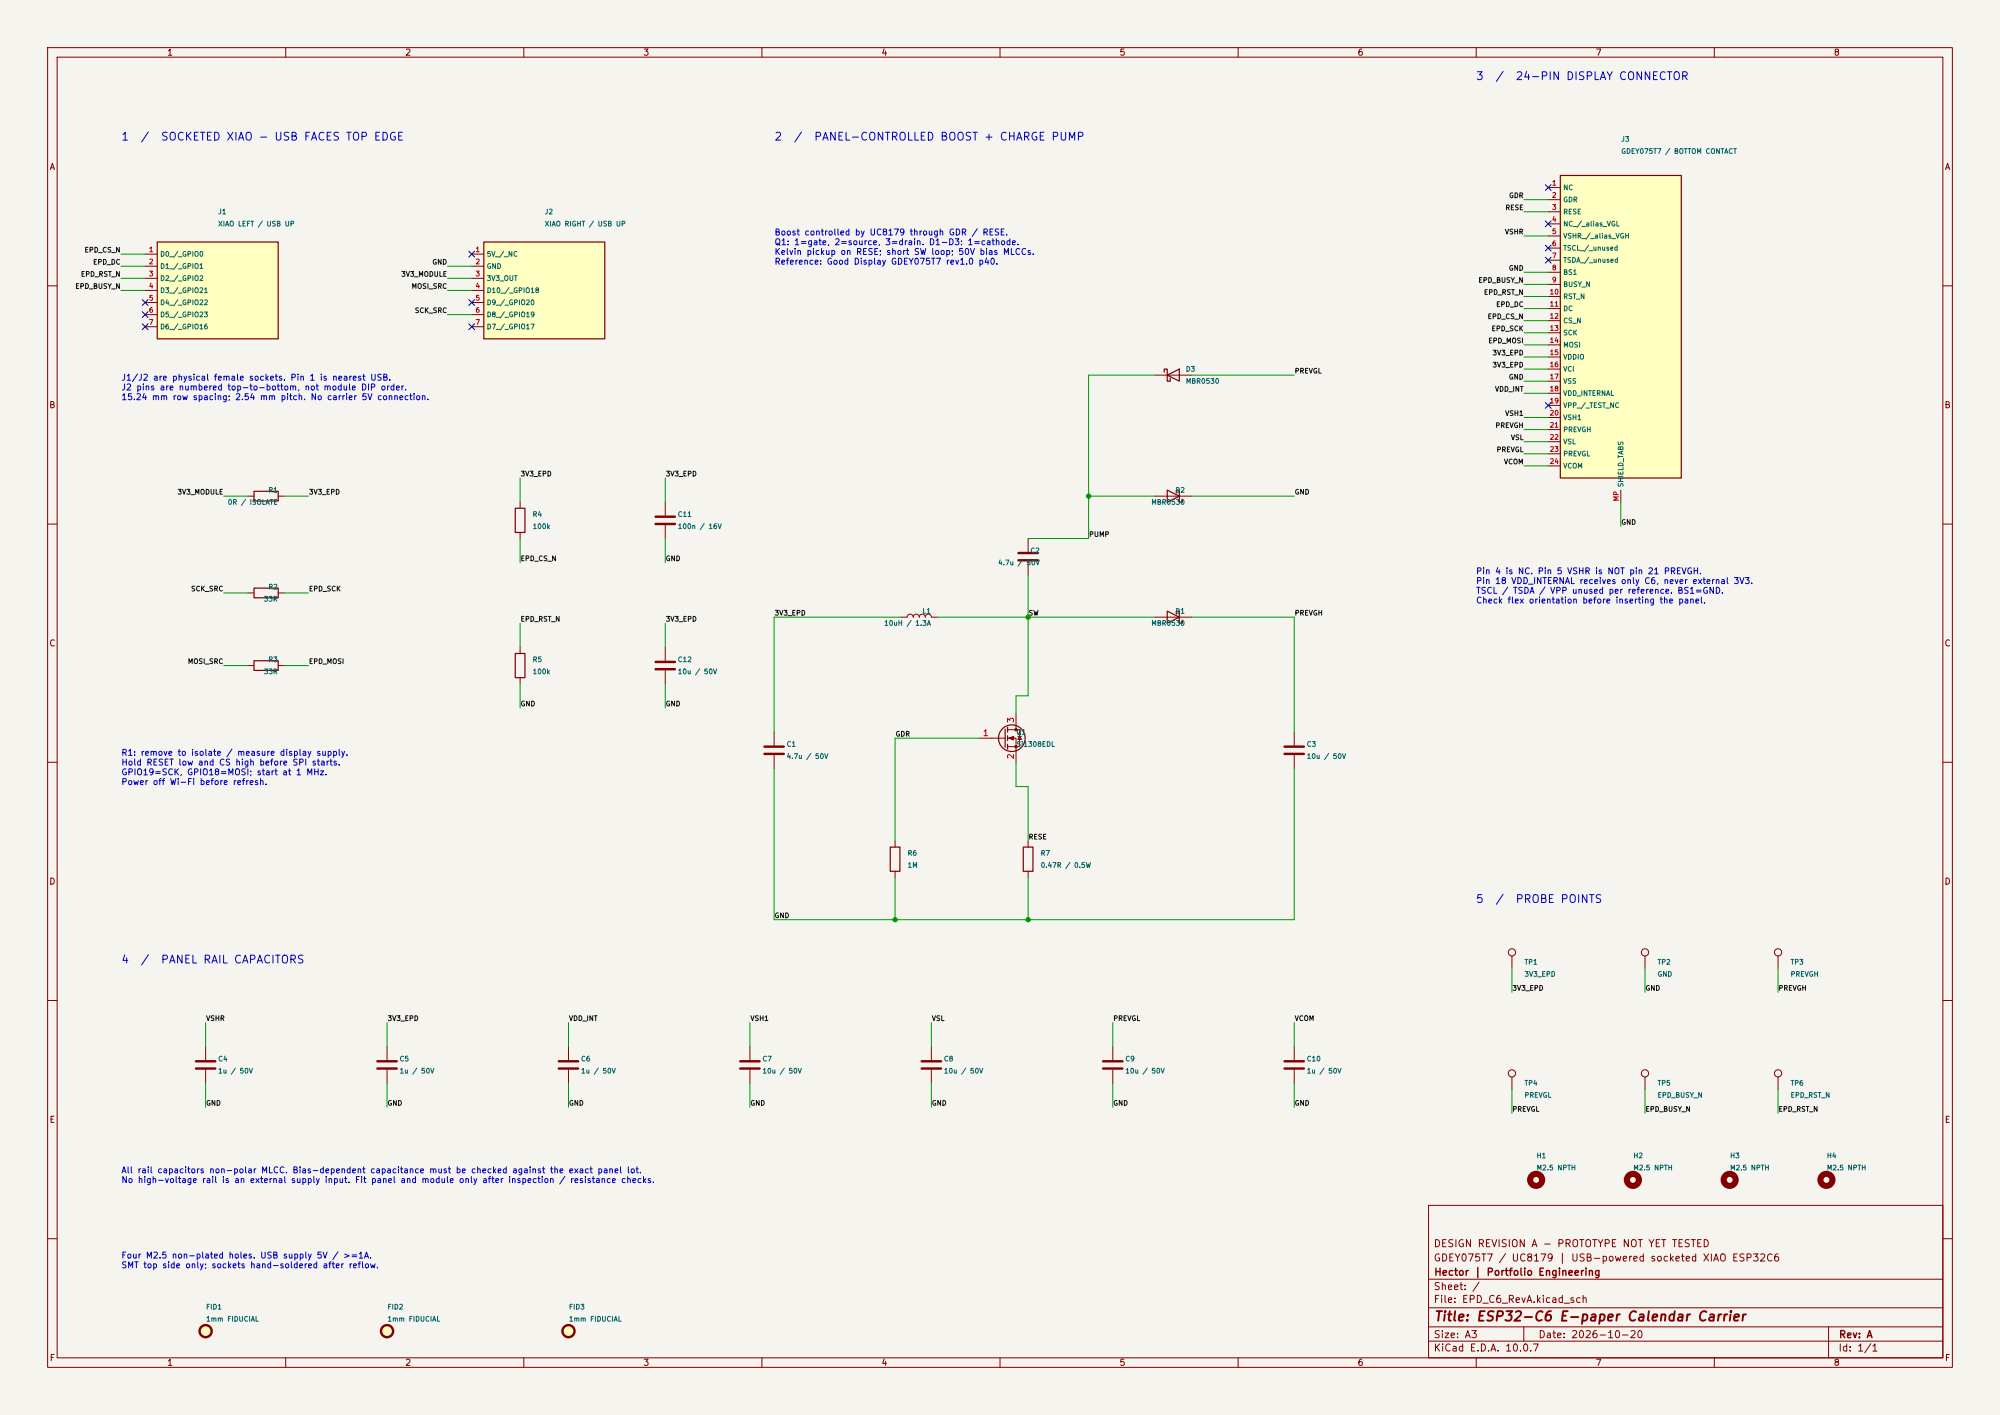
[picture p10: page 1]

1 / SOCKETED XIAO - USB FACES TOP EDGE

2 / PANEL-CONTROLLED BOOST + CHARGE PUMP

XIAO LEFT / USB UP

XIAO RIGHT / USB UP

Boost controlled by UC8179 through GDR / RESE. Q1: 1=gate, 2=source, 3=drain. D1-D3: 1=cathode. Kelvin pickup on RESE; short SW loop; 50V bias MLCCs. Reference: Good Display GDEY075T7 rev1.0 p40.

DESIGN REVISION A - PROTOTYPE NOT YET TESTED
GDEY075T7 / UC8179 | USB-powered socketed XIAO ESP32C6
Hector | Portfolio Engineering
Sheet: /
File: EPD_C6_RevA.kicad_sch
Title: ESP32-C6 E-paper Calendar Carrier

Size: A3 | Rev: A | F Date: 2026-10-20
KiCad E.D.A. 10.0.7 | Id: 1/1
