xmyoot/esp32c6-epaper-calendar/docs/EPD_C6_RevA-assembly.pdf

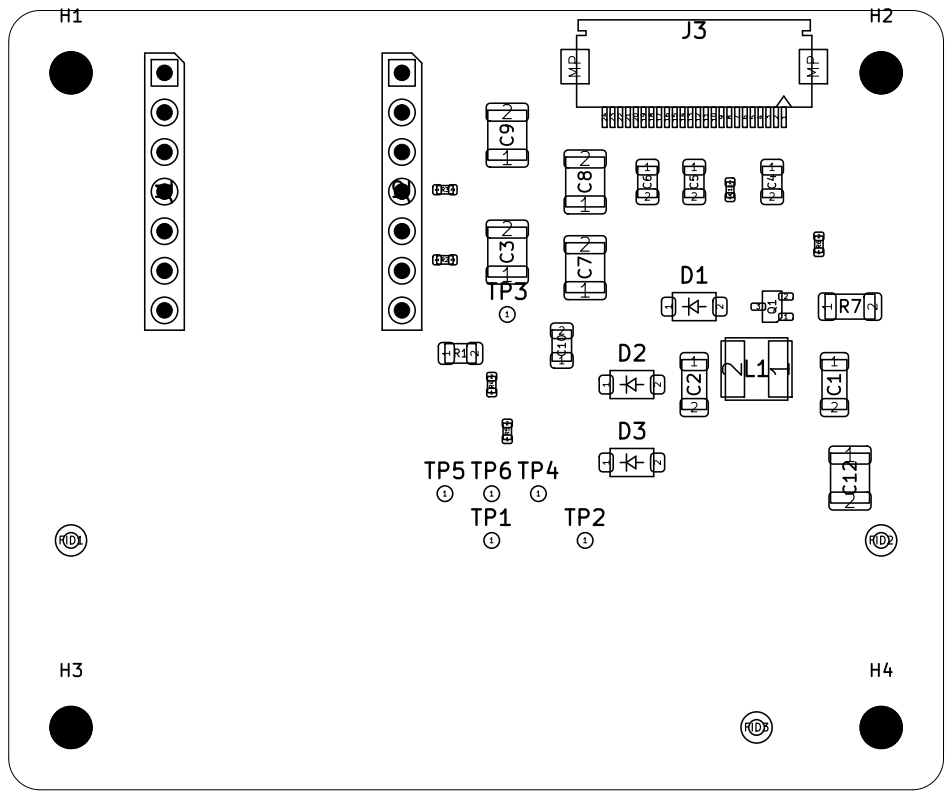
[picture p11: page 1]

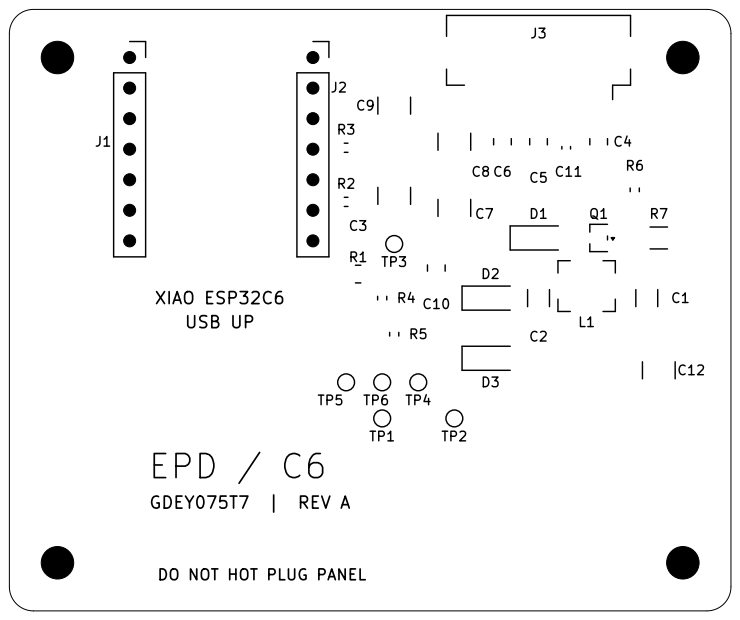
[picture p12: page 2]

DO NOT HOT PLUG PANEL
