xmyoot/esp32c6-epaper-calendar/hardware/EPD_C6_RevA.kicad_pcb

## KiCad design hardware/EPD_C6_RevA.kicad_pcb (2026-10-21)

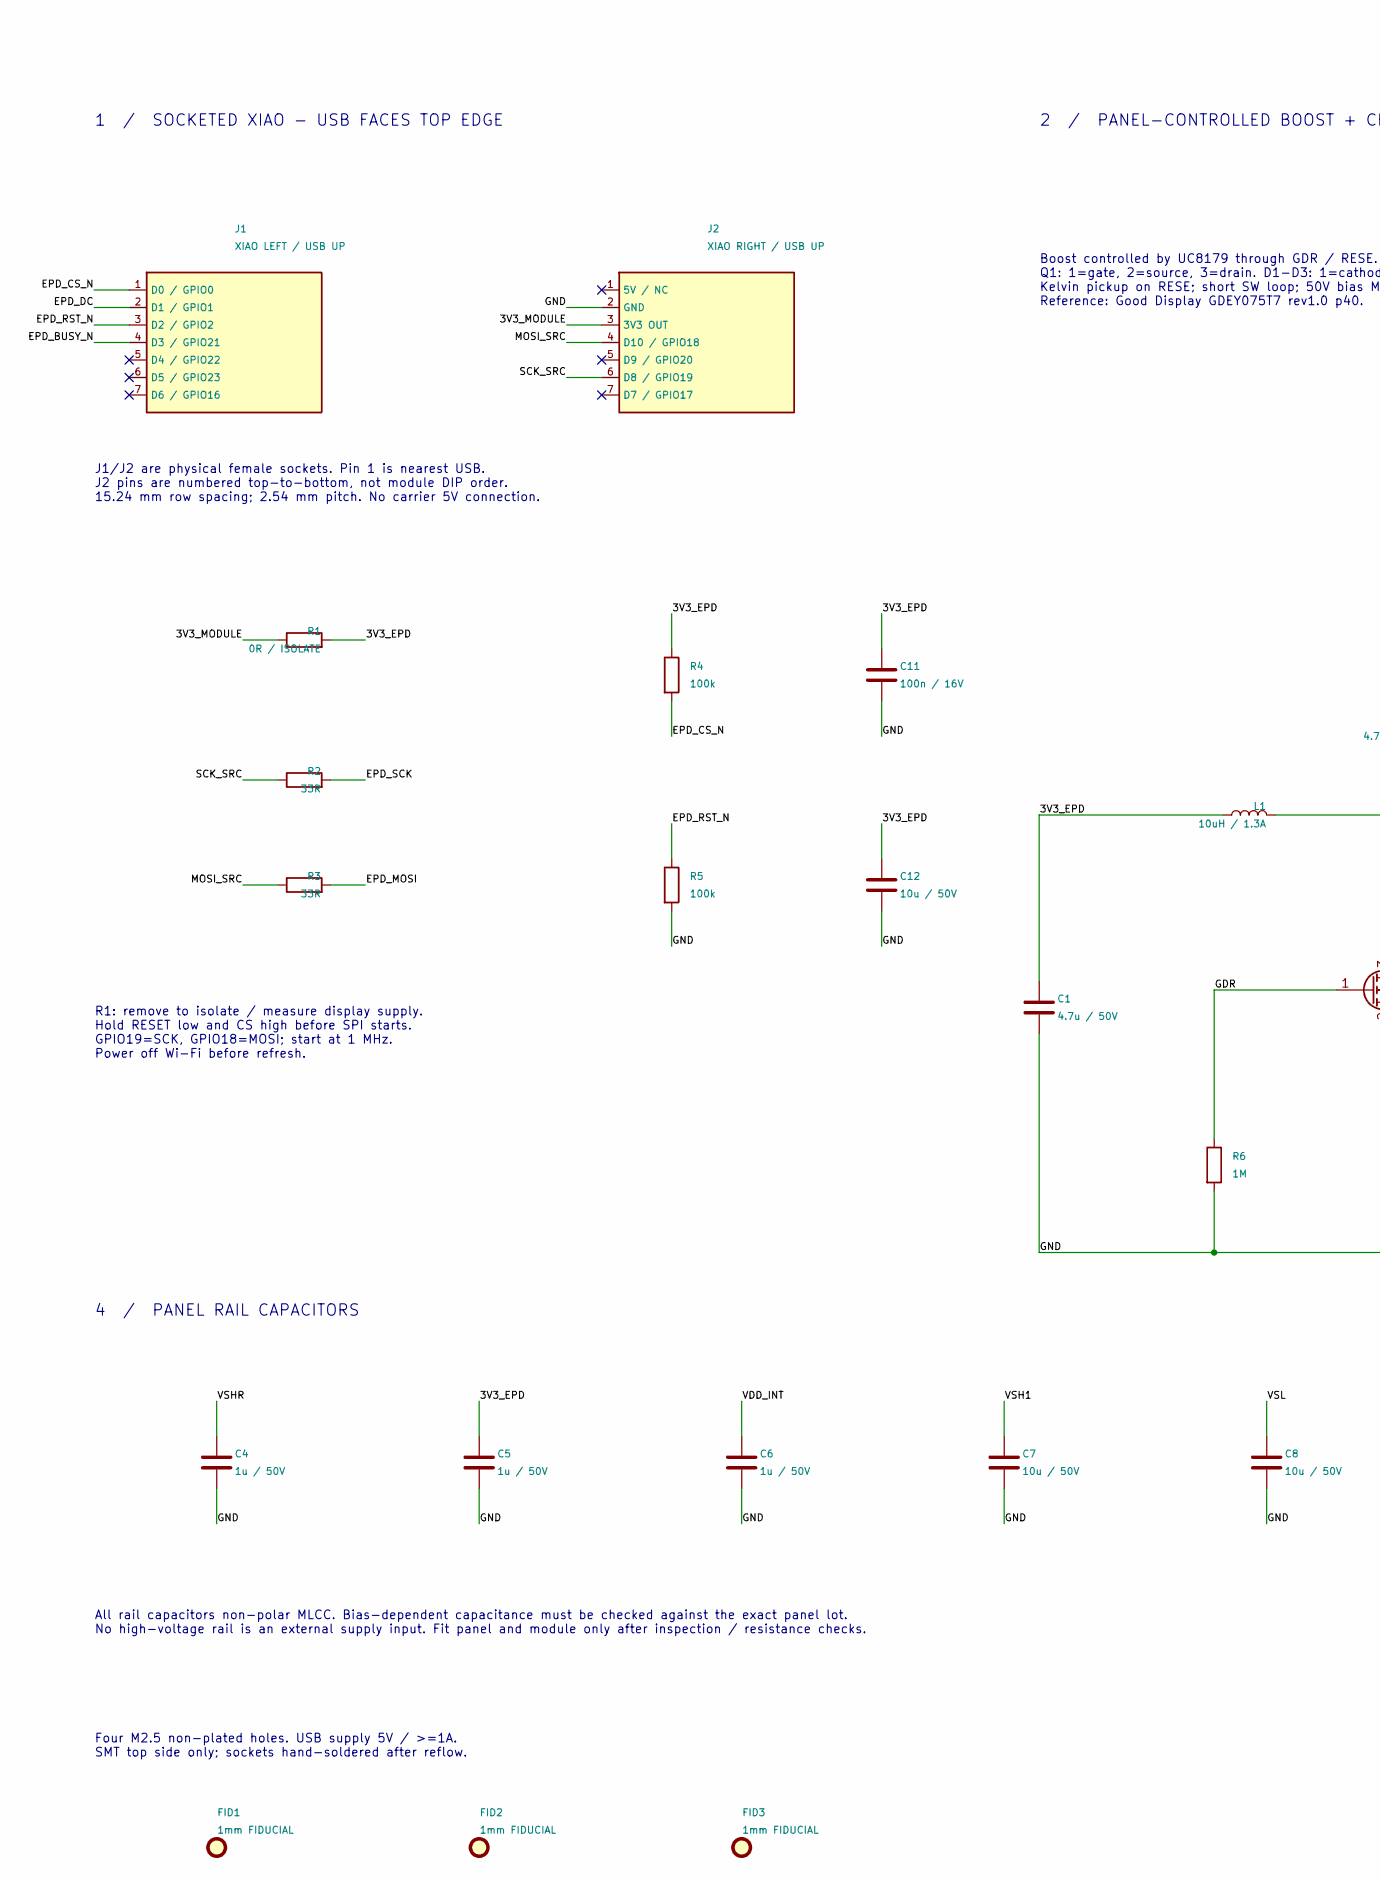
[picture p13: schematic EPD_C6_RevA.kicad_sch, ESP32-C6 E-paper Calendar Carrier, part in row 1, column 1]

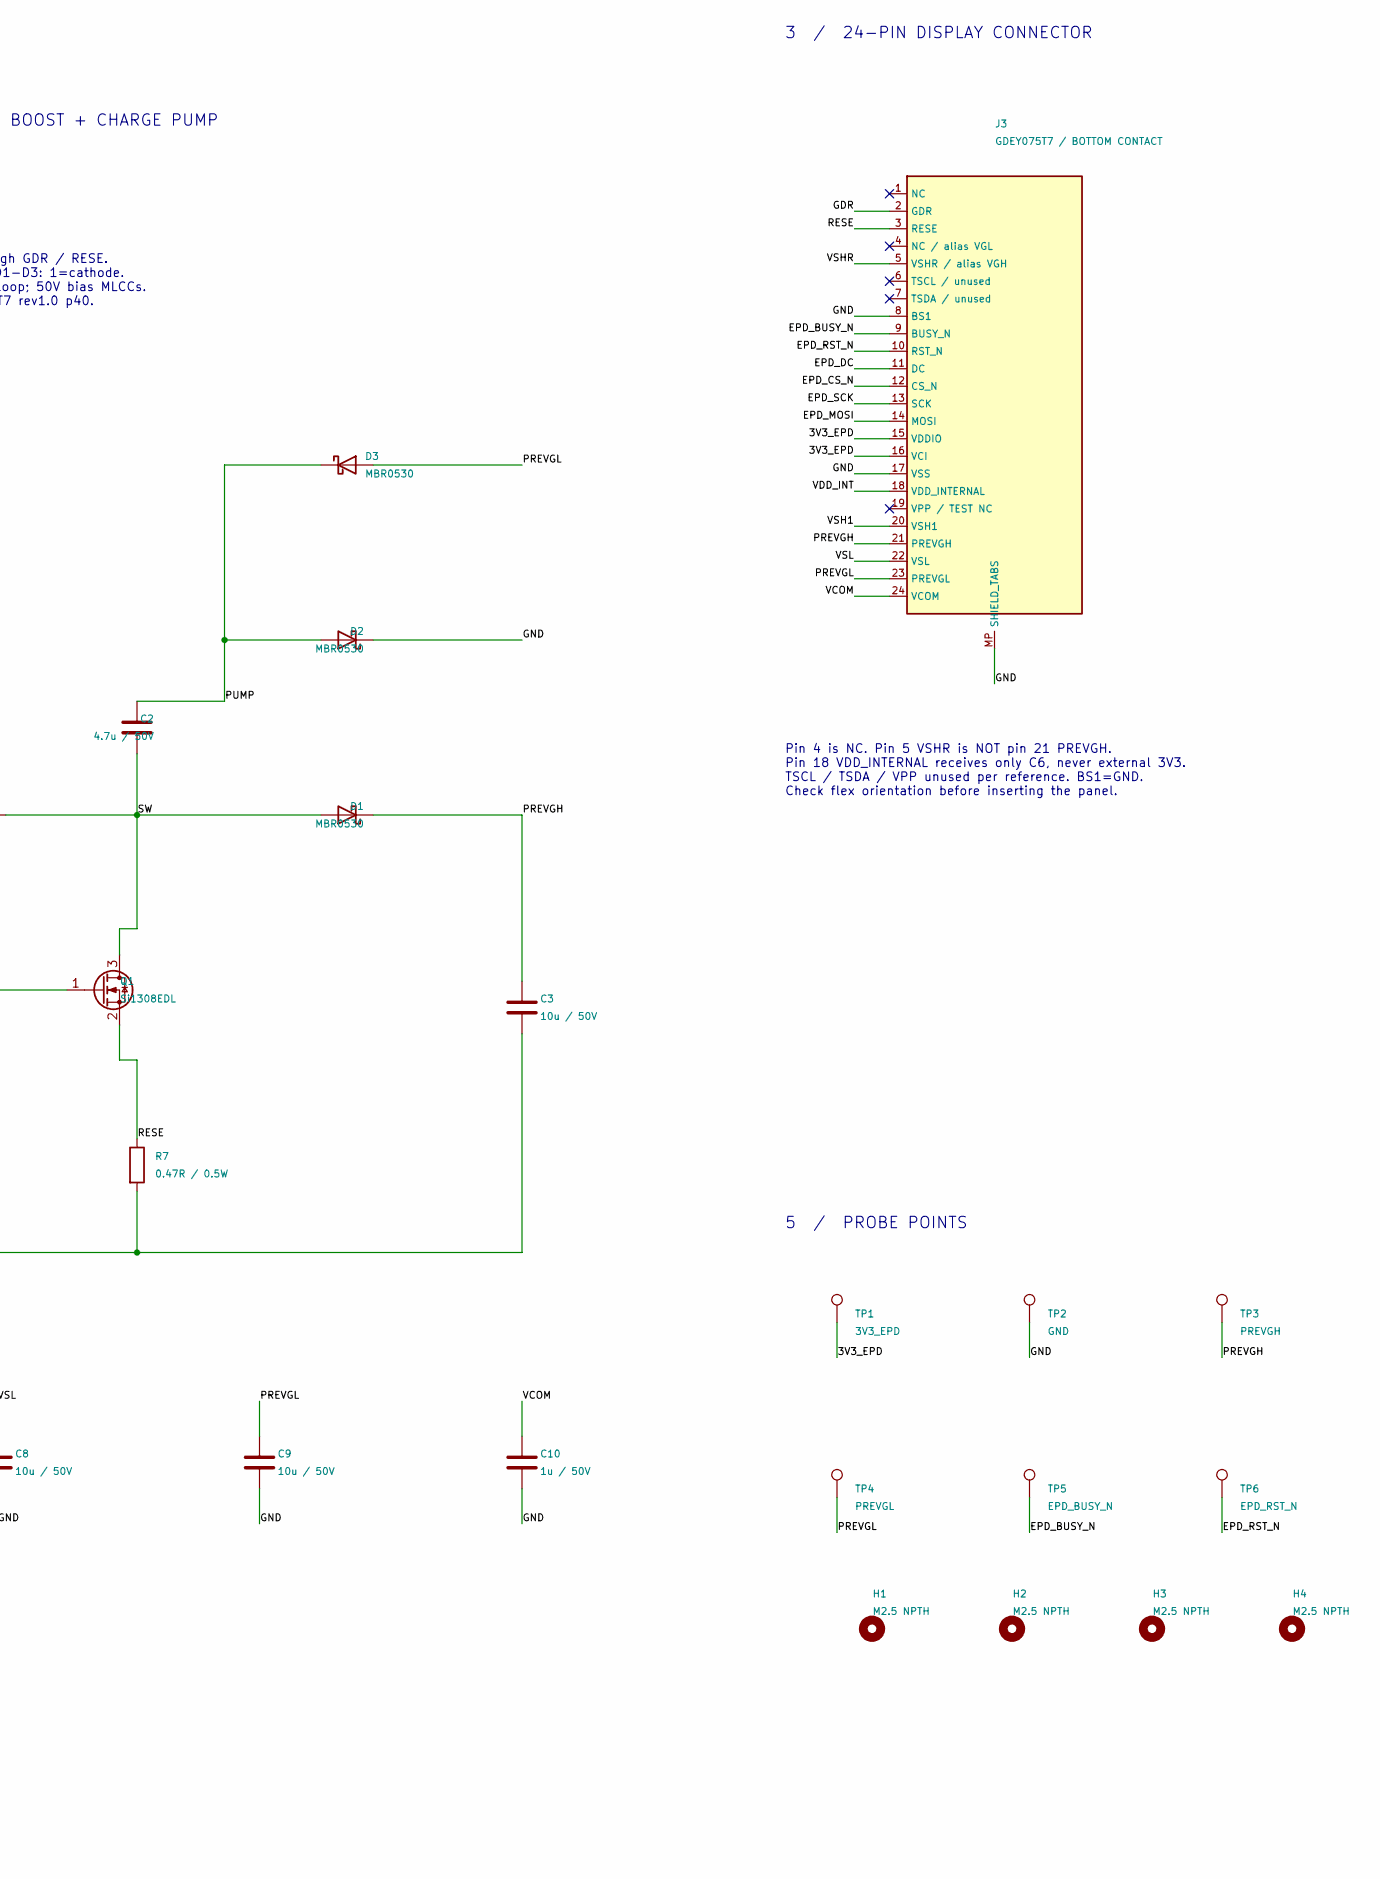
[picture p14: schematic EPD_C6_RevA.kicad_sch, ESP32-C6 E-paper Calendar Carrier, part in row 1, column 2]

Parts:
C1, C2: 4.7u / 50V; C_1206_3216Metric; MPN CC1206KKX7R9BB475; LCSC C132170
C3, C7, C8, C9, C12: 10u / 50V; C_1210_3225Metric; MPN GRM32ER71H106KA12L; LCSC C77102
C4, C5, C6, C10: 1u / 50V; C_0805_2012Metric; MPN GRM21BR71H105KA12L; LCSC C77083
C11: 100n / 16V; C_0402_1005Metric; MPN CL05B104KO5NNNC; LCSC C1525
D1, D2, D3: MBR0530; D_SOD-123; MPN MBR0530; LCSC C77336
FID1, FID2, FID3: 1mm FIDUCIAL; Fiducial_1mm_Mask2mm
H1, H2, H3, H4: M2.5 NPTH; MountingHole_2.7mm_M2.5
J1: XIAO LEFT / USB UP; PinSocket_1x07_P2.54mm_Vertical; MPN SSW-107-01-G-S
J2: XIAO RIGHT / USB UP; PinSocket_1x07_P2.54mm_Vertical; MPN SSW-107-01-G-S
J3: GDEY075T7 / BOTTOM CONTACT; Hirose_FH12-24S-0.5SH_1x24-1MP_P0.50mm_Horizontal; MPN FH12-24S-0.5SH(55); LCSC C202112
L1: 10uH / 1.3A; L_Bourns-SRN4018; MPN SRN4018-100M; LCSC C503307
Q1: Si1308EDL; SOT-323_SC-70; MPN SI1308EDL-T1-GE3; LCSC C469327
R1: 0R / ISOLATE; R_0805_2012Metric; MPN 0805W8F0000T5E; LCSC C17477
R2, R3: 33R; R_0402_1005Metric; MPN 0402WGF330JTCE; LCSC C25105
R4, R5: 100k; R_0402_1005Metric; MPN 0402WGF1003TCE; LCSC C25741
R6: 1M; R_0402_1005Metric; MPN 0402WGF1004TCE; LCSC C26083
R7: 0.47R / 0.5W; R_1206_3216Metric; MPN RL1206FR-7W0R47L; LCSC C859932
TP1: 3V3_EPD; TestPoint_Pad_D1.0mm
TP2: GND; TestPoint_Pad_D1.0mm
TP3: PREVGH; TestPoint_Pad_D1.0mm
TP4: PREVGL; TestPoint_Pad_D1.0mm
TP5: EPD_BUSY_N; TestPoint_Pad_D1.0mm
TP6: EPD_RST_N; TestPoint_Pad_D1.0mm

Connections:
/3V3_EPD: C1.1, C5.1, C11.1, C12.1, J3.15 (VDDIO), J3.16 (VCI), L1.1, R1.2, R4.1, TP1.1
/3V3_MODULE: J2.3 (3V3 OUT), R1.1
/EPD_BUSY_N: J1.4 (D3 / GPIO21), J3.9 (BUSY_N), TP5.1
/EPD_CS_N: J1.1 (D0 / GPIO0), J3.12 (CS_N), R4.2
/EPD_DC: J1.2 (D1 / GPIO1), J3.11 (DC)
/EPD_MOSI: J3.14 (MOSI), R3.2
/EPD_RST_N: J1.3 (D2 / GPIO2), J3.10 (RST_N), R5.1, TP6.1
/EPD_SCK: J3.13 (SCK), R2.2
/GDR: J3.2 (GDR), Q1.1 (G), R6.1
/GND: C1.2, C3.2, C4.2, C5.2, C6.2, C7.2, C8.2, C9.2, C10.2, C11.2, C12.2, D2.1 (K), J2.2 (GND), J3.8 (BS1), J3.17 (VSS), J3.MP (SHIELD_TABS), R5.2, R6.2, R7.2, TP2.1
/MOSI_SRC: J2.4 (D10 / GPIO18), R3.1
/PREVGH: C3.1, D1.1 (K), J3.21 (PREVGH), TP3.1
/PREVGL: C9.1, D3.2 (A), J3.23 (PREVGL), TP4.1
/PUMP: C2.2, D2.2 (A), D3.1 (K)
/RESE: J3.3 (RESE), Q1.2 (S), R7.1
/SCK_SRC: J2.6 (D8 / GPIO19), R2.1
/SW: C2.1, D1.2 (A), L1.2, Q1.3 (D)
/VCOM: C10.1, J3.24 (VCOM)
/VDD_INT: C6.1, J3.18 (VDD_INTERNAL)
/VSH1: C7.1, J3.20 (VSH1)
/VSHR: C4.1, J3.5 (VSHR / alias VGH)
/VSL: C8.1, J3.22 (VSL)

Notes on the sheet:
1 / SOCKETED XIAO - USB FACES TOP EDGE
2 / PANEL-CONTROLLED BOOST + CHARGE PUMP
3 / 24-PIN DISPLAY CONNECTOR
4 / PANEL RAIL CAPACITORS
5 / PROBE POINTS
J1/J2 are physical female sockets. Pin 1 is nearest USB. J2 pins are numbered top-to-bottom, not module DIP order. 15.24 mm row spacing; 2.54 mm pitch. No carrier 5V connection.
R1: remove to isolate / measure display supply. Hold RESET low and CS high before SPI starts. GPIO19=SCK, GPIO18=MOSI; start at 1 MHz. Power off Wi-Fi before refresh.
Boost controlled by UC8179 through GDR / RESE. Q1: 1=gate, 2=source, 3=drain. D1-D3: 1=cathode. Kelvin pickup on RESE; short SW loop; 50V bias MLCCs. Reference: Good Display GDEY075T7 rev1.0 p40.
Pin 4 is NC. Pin 5 VSHR is NOT pin 21 PREVGH. Pin 18 VDD_INTERNAL receives only C6, never external 3V3. TSCL / TSDA / VPP unused per reference. BS1=GND. Check flex orientation before inserting the panel.
All rail capacitors non-polar MLCC. Bias-dependent capacitance must be checked against the exact panel lot. No high-voltage rail is an external supply input. Fit panel and module only after inspection / resistance checks.
Four M2.5 non-plated holes. USB supply 5V / >=1A. SMT top side only; sockets hand-soldered after reflow.

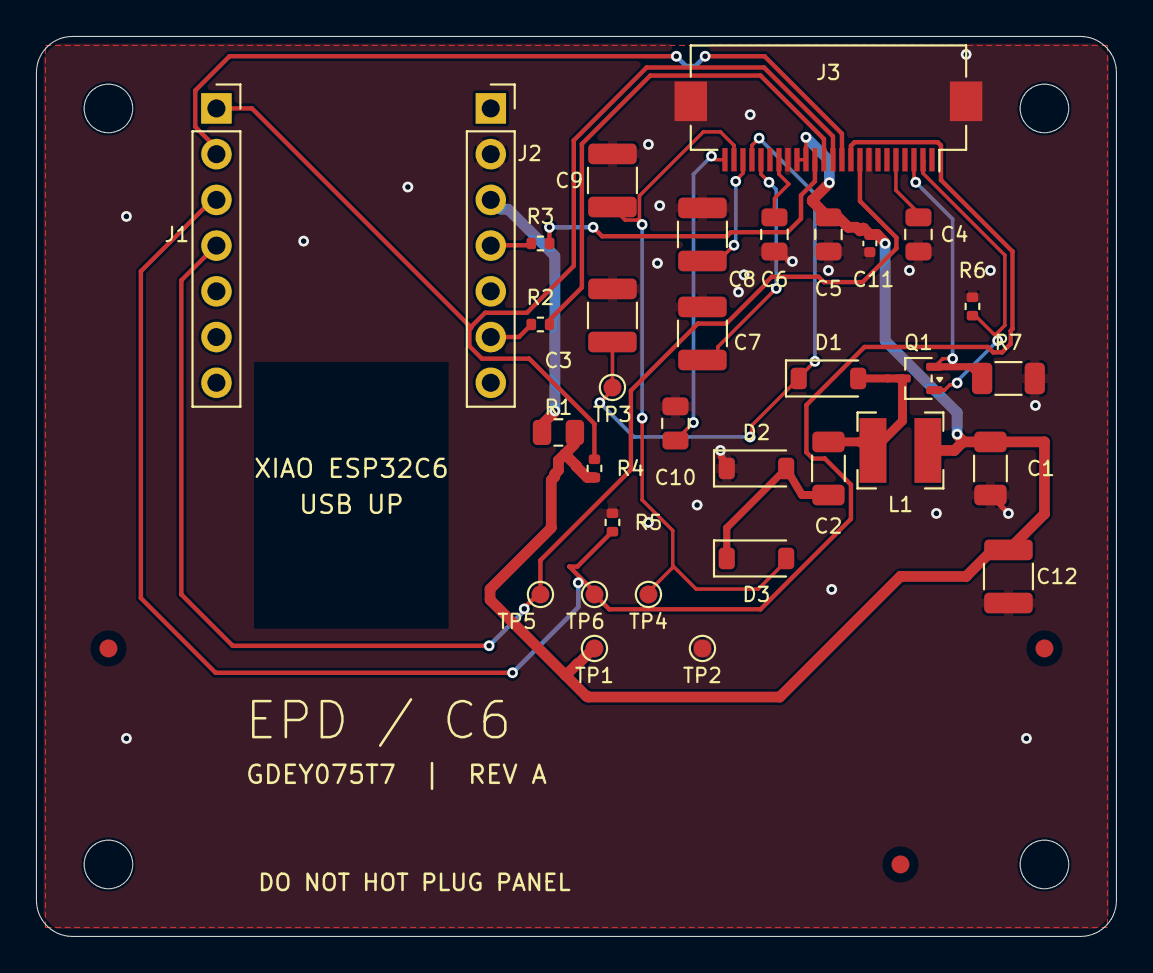
[picture p15: board EPD_C6_RevA.kicad_pcb from above]

Board: 2 copper layers, 60.0 x 50.0 mm, 40 parts (0 on the bottom side), 22 nets.
