xmyoot/esp32c6-epaper-calendar/scripts/floorplan.py

# Reviewed floorplan: USB and panel cable leave the top edge; bias section stays right.
POSITIONS={
'J3':(144,105,180),'R1':(129,122,0),'R2':(128,116,0),'R3':(128,111.5,0),
'R4':(131,124,90),'R5':(132,127,90),'L1':(148,123,180),'Q1':(149,119,180),'R6':(152,115,90),'R7':(154,119,0),
'D1':(144,119,0),'D2':(140,124,0),'D3':(140,129,0),'C1':(153,124,270),'C2':(144,124,270),'C3':(132,115.5,90),
'C4':(149,111,270),'C5':(144,111,270),'C6':(141,111,270),'C7':(137,116.5,90),'C8':(137,111,90),
'C9':(132,108,90),'C10':(135.5,121.5,90),'C11':(146.3,111.5,270),'C12':(154,130,270),
'TP1':(131,134,0),'TP2':(137,134,0),'TP3':(132,119.5,0),'TP4':(134,131,0),'TP5':(128,131,0),'TP6':(131,131,0)}
