xmyoot/esp32c6-epaper-calendar/scripts/project_settings.py

from design import *
# No severity suppression or DRC exclusions. Conservative two-layer production rules.
settings={'meta':{'filename':NAME+'.kicad_pro','version':3},'board':{'design_settings':{'rules':{'min_clearance':.2,'min_track_width':.2,'min_via_diameter':.6,'min_through_hole_diameter':.3,'min_via_annular_width':.15,'min_hole_to_hole':.25,'min_copper_edge_clearance':.3,'min_silk_clearance':.1,'min_silk_text_height':.8,'min_silk_text_thickness':.12},'defaults':{'board_outline_line_width':.05,'copper_line_width':.25,'silk_line_width':.12,'silk_text_size_h':1,'silk_text_size_v':1,'silk_text_thickness':.15},'track_widths':[0,.25,.4,.6],'via_dimensions':[{'diameter':.6,'drill':.3}]}},'net_settings':{'classes':[{'name':'Default','clearance':.2,'track_width':.25,'via_diameter':.6,'via_drill':.3,'microvia_diameter':.3,'microvia_drill':.1,'diff_pair_width':.25,'diff_pair_gap':.25,'diff_pair_via_gap':.25,'bus_width':12,'wire_width':6,'line_style':0,'pcb_color':'rgba(0, 0, 0, 0.000)','schematic_color':'rgba(0, 0, 0, 0.000)'}],'netclass_assignments':{},'netclass_patterns':[],'meta':{'version':4}},'text_variables':{}}
(ROOT/'hardware'/(NAME+'.kicad_pro')).write_text(json.dumps(settings,indent=2))
(ROOT/'hardware'/(NAME+'.kicad_dru')).write_text('(version 1)\n# Default 0.20mm minimum includes the fixed 0.20mm FH12 pad gap.\n# Prefer 0.30mm spacing on bias traces outside the connector escape.\n')
(ROOT/'hardware/fp-lib-table').write_text('(fp_lib_table (version 7) '+''.join('(lib (name "'+lib+'")(type "KiCad")(uri "${KIPRJMOD}/Carrier.pretty")(options "")(descr "Vendored KiCad footprint subset"))' for lib in sorted(set(p['footprint'].split(':')[0] for p in parts)|{'Carrier'}))+')')
